WeisTekEng/openfixture/openfixture.scad

/**
 *  OpenFixture - The goal is to have a turnkey pcb fixturing solution
 *  as long as you have access to a laser cutter or laser cutting service.
 *
 *  The input is:
 *   1. (x, y) work area that is >= pcb size
 *   2. (x, y) cooridates of test point centers
 *   3. dxf of pcb outline aligned with (0,0) on the top left.
 *   4. Material parameters: acrylic thickness, kerf, etc
 *
 *  The output is a dxf containing all the parts (minus M3 hardware
 *  to assemble the fixture.
 *
 *  Creative Commons Licensed  (CC BY-SA 4.0)
 *  Tiny Labs
 *  2016
 */
 
use <Videopac.otf>
 
//
// PCB input
//

 // Test points
test_points = [
    [4.85, 19.95],
    [2.85, 21.25],
    [4.85, 22.45],
    [2.85, 23.7],
    [4.85, 24.95],
    [2.85, 26.2],
    [4.85, 27.45],
    [22.1, 18.8],
    [23.4, 30.95],
];

// Used below to calculate distance from hinge to nearest point based on min
// contact angle... Ideally we want it as close to 90 degrees as possible
// All you have to know is look through 'y' column above and set to lowest val
tp_min_y = 18.8;

// DXF outline of pcb
pcb_outline = "/home/elliot/projects/openfixture/keysy_outline.dxf";
osh_logo = "./osh_logo.dxf";


// Should be close to actual pcb dimensions... Used for support structure only so not critical
pcb_x = 27.14;
pcb_y = 45;
pcb_support_border = 2;

// Work area of PCB
// Must be >= PCB size
// If you make this as big as any of the PCBs you work with you could then reuse the base and just
// swap the head and carriers based on the pcb you're using 
work_area_x = 28;
work_area_y = 46;

// Thickness of pcb
pcb_th = 0.8;
//pcb_th = 1.6;  // Standard PCB size

// Correction offset
// These are final adjustments relative to the board carrier.
// Usually these aren't needed but can be used to tweak alignment
tp_correction_offset_x = 0.0;
tp_correction_offset_y = 0.0;

// Uncomment for alignment check, can be a quick sanity check to
// make sure everything lines up.
//projection (cut = false) alignment_check ();

// Uncomment for laser cuttable dxf
//projection (cut = false) lasercut (); // Uncomment for exportable dxf to laser cut
//3d_model (); // Uncomment for full 3d rendering
//3d_head ();  // Uncomment for 3d head rendering
//3d_base ();  // Uncomment for 3d base rendering 

//3D printing stuff. Export a piece at a time and import into your favorite
//software generate Gcode and print. A plate option will be done later.
//**BASE STUFF**
//3d_base_Spacers(); //sides of base.
//3d_base_hinge(); //Base Back side hinge.
//3d_base_supports();
//3d_base_bed_support();
//3d_base_bed_carrier();
//**END BASE STUFF**

//**TOP BED STUFF**
//3d_head_base();
//3d_head_side();
//3d_head_top();
//3d_front_back();
//**END TOP BED STUFF**
//
// End PCB input

// Smothness function for circles
$fn = 15;

// All measurements in mm
// Material parameters
// 0.10"
//mat_th = 2.5;
// 0.125" (1/8 ")
mat_th = 3.175;

// Kerf adjustment
kerf = 0.125;

// Space between laser parts
laser_pad = 2;

// Screw radius (we want this tight to avoid play)
// This should work for M3 hardware
// Just the threads, not including head
// Should be no less than 12
screw_thr_len = 14;
screw_d = 2.9;
screw_r = screw_d / 2;

// Uncomment to use normal M3 screw for pivot
pivot_d = screw_d;
// Uncomment to use bushing
//pivot_d = 5.12;
pivot_r = pivot_d / 2;

// Metric M3 hex nut dimensions
// f2f = flat to flat
nut_od_f2f = 5.45;
nut_od_c2c = 6;
nut_th = 2.25;

// Pogo pin receptable dimensions
// I use the 2 part pogos with replaceable pins. Its a lifer save when a pin breaks
// Undersized so they can be carefully drilled out using #48 drill bit for better precision
// If you have access to a nicer laser you can size these exactly
pogo_r = 1.5 / 2;

// Uncompressed length from receptacle
pogo_uncompressed_length = 8;
pogo_compression = 1;

// Locking tab parameters
tab_width = 3 * mat_th;
tab_length = 4 * mat_th;

// Stop tab
stop_tab_y = 2 * mat_th;

//
// DO NOT EDIT below unless you feel like it ;-)
//
// Calculate min distance to hinge with a constraint on
// the angle of the pogo pin when it meets compression with the board.
// a = compression
// c = active_y_offset + pivot_d
// cos (min_angle) = a^2 / (2ca)
//min_angle = 89.2;
min_angle = 89.5;

// Calculate active_y_back_offset
active_y_back_offset = (pow (pogo_compression, 2) / (cos (min_angle) * 2 * pogo_compression)) - pivot_d - tp_min_y;

// Active area parameters
active_x_offset = 2 * mat_th + nut_od_f2f + 2;
active_y_offset = 2 * mat_th + nut_od_f2f + 2;

// Head dimensions
head_x = work_area_x + 2 * active_x_offset;
head_y = work_area_y + active_y_offset + active_y_back_offset;
head_z = screw_thr_len + (mat_th - nut_th);

// Base dimensions
base_x = head_x + 2 * mat_th;
base_y = head_y + 2 * pivot_d;
base_z = screw_thr_len + 3 * mat_th;
base_pivot_offset = pivot_d + (pogo_uncompressed_length - pogo_compression) - (mat_th - pcb_th);

//
// MODULES
//
module tnut_female (n)
{
    // How much grip material
    tnut_grip = 4;
    
    // Pad for screw
    pad = 0.4;
    screw_len_pad = 1;
    
    // Screw hole
    translate ([0, -screw_r - pad/2, 0])
    cube ([screw_thr_len + screw_len_pad, screw_d + pad, mat_th]);
    
    // Make space for nut
    translate ([mat_th * n + tnut_grip, -nut_od_f2f/2, 0])
    cube ([nut_th, nut_od_f2f, mat_th]);
}

module tnut_hole ()
{
    pad = 0.1;
    cylinder (r = screw_r + pad, h = mat_th, $fn = 20);
}

module tng_n (length, cnt)
{
    tng_y = (length / cnt);
    
    translate ([0, -length / 2, 0])
    union () {
        for (i = [0 : 2 : cnt - 1]) {
            translate ([0, i * tng_y, 0])
            cube ([mat_th, tng_y, mat_th]);
        }
    }
}

module tng_p (length, cnt)
{
    tng_y = length / cnt;
    
    translate ([0, -length / 2, 0])
    union () {
        for (i = [1 : 2 : cnt - 1]) {
            translate ([0, i * tng_y, 0])
            cube ([mat_th, tng_y, mat_th]);
        }
    }
}


module spacer ()
{
    difference () {
        cylinder (r = screw_d, h = mat_th);
        cylinder (r = screw_r, h = mat_th);
    }
}

module nut_hole ()
{
    difference () {
        cylinder (r = nut_od_c2c/2, h = mat_th, $fn = 6);
        //cylinder (r = screw_r, h = mat_th, $fn = 20);
    }
}

module head_side ()
{
    x = head_z;
    y = head_y;
    r = pivot_d;
    
    difference () {
        union () {
            hull () {
                translate ([0, y, 0])
                cube ([x, 0.01, mat_th]);
                
                // Add pivot point
                translate ([r, y + r, 0])
                cylinder (r = r, h = mat_th, $fn = 20);
            }
            cube ([x, y, mat_th]);
        }
            
        // Remove pivot
        translate ([r, y + r, 0])
        cylinder (r = r/2, h = mat_th, $fn = 20);
        
        // Remove slots
        translate ([0, y / 2, 0])
        tng_n (y, 3);
        translate ([x - mat_th, y / 2, 0])
        tng_n (y, 3);
        
        // Remove lincoln log slots
        translate ([0, mat_th, 0])
        cube ([x / 2, mat_th, mat_th]);
        translate ([0, y - 2 * mat_th, 0])
        cube ([x / 2, mat_th, mat_th]);
    }
}

module head_front_back ()
{
    x = head_x + 2 * mat_th;
    y = head_z;
    
    difference () {
        cube ([x, y, mat_th]);
        
        // Remove grooves
        translate ([x / 2, 0, 0])
        rotate ([0, 0, 90])
        tng_n (x, 3);
        translate ([x / 2, y - mat_th, 0])
        rotate ([0, 0, 90])
        tng_n (x, 3);
        
        // Remove assembly slots
        translate ([2 *mat_th, y / 2, 0])
        cube ([mat_th, y / 2, mat_th]);
        translate ([x - 3 * mat_th, y / 2, 0])
        cube ([mat_th, y / 2, mat_th]);
    }
}

module lock_tab ()
{
    translate ([-tab_length/2, 0, 0])
    cube ([tab_length, tab_width, mat_th]);
    translate ([-tab_length/2, tab_width/2, 0])
    cylinder (r = tab_width / 2, h = mat_th, $fn = 20);
}

module head_base ()
{
    nut_offset = 2 * mat_th + screw_r;
    
    difference () {
        
        union () {
            // Common base
            head_base_common ();

            // Add stop tabs
            translate ([head_x, head_y - stop_tab_y + 2 * kerf, 0])
            cube ([mat_th, stop_tab_y, mat_th]);
            translate ([-mat_th, head_y - stop_tab_y + 2 * kerf, 0])
            cube ([mat_th, stop_tab_y, mat_th]);

            // Add lock tabs
            lock_tab ();
            translate ([head_x, 0, 0])
            mirror ([1, 0, 0])
            lock_tab ();

        }

        // Remove holes for hex nuts
        translate ([nut_offset, nut_offset, 0])
        nut_hole ();
        translate ([nut_offset, head_y - nut_offset, 0])
        nut_hole ();
        translate ([head_x - nut_offset, head_y - nut_offset, 0])
        nut_hole ();
        translate ([head_x - nut_offset, nut_offset, 0])
        nut_hole ();
        
        // Take 1/4 mouse bit out of front of tabs
        translate ([-2 * mat_th, 0, 0])
        cube ([mat_th, tab_width / 4, mat_th]);
        translate ([head_x + mat_th, 0, 0])
        cube ([mat_th, tab_width / 4, mat_th]);
    }
}
module osh_logo () {
    linear_extrude (height = mat_th)
    scale ([0.2, 0.2, 1])
    translate ([-72, -66, 0])
    import (osh_logo);
}

module head_top ()
{
    hole_offset = 2 * mat_th + screw_r;
    pad = 0.1;
    
    difference () {
        
        // Common base
        head_base_common ();
        
        // Remove holes for hex nuts
        translate ([hole_offset, hole_offset, 0])
        cylinder (r = screw_r + pad, h = mat_th);
        translate ([hole_offset, head_y - hole_offset, 0])
        cylinder (r = screw_r + pad, h = mat_th);
        translate ([head_x - hole_offset, head_y - hole_offset, 0])
        cylinder (r = screw_r + pad, h = mat_th);
        translate ([head_x - hole_offset, hole_offset, 0])
        cylinder (r = screw_r + pad, h = mat_th);

        // Add osh logo
        translate ([head_x / 2, head_y - 25, 0])
        osh_logo ();
    }
}

module head_base_common ()
{
    difference () {
        
        // Base cube
        cube ([head_x, head_y, mat_th]);
                
        // Remove slots
        translate ([mat_th, head_y / 2, 0])
        tng_p (head_y, 3);
        translate ([head_x - 2 * mat_th, head_y / 2, 0])
        tng_p (head_y, 3);
        translate ([head_x / 2, head_y - 2 * mat_th, 0])
        rotate ([0, 0, 90])
        tng_p (head_x + 2 * mat_th, 3);
        translate ([head_x / 2, mat_th, 0])        
        rotate ([0, 0, 90])
        tng_p (head_x + 2 * mat_th, 3);
        
        // Calc (x,y) origin = (0, 0)
        origin_x = active_x_offset;
        origin_y = active_x_offset + work_area_y;
    
        // Loop over test points
        for ( i = [0 : len (test_points) - 1] ) {
        
            // Drop pins for test points
            translate ([origin_x + test_points[i][0], origin_y - test_points[i][1], 0])
            cylinder (r = pogo_r, h = mat_th);
        }
    }
}

module latch ()
{
    pad = tab_width / 12;
    
    y = base_z * (2 / 3) + base_pivot_offset - pivot_d;
    difference () {
        
        hull () {
            cylinder (r = tab_width / 2, h = mat_th, $fn = 20);
            translate ([0, y + screw_d, 0])
            cylinder (r = tab_width / 2, h = mat_th, $fn = 20);
        }
        
        cylinder (r = screw_r, h = mat_th, $fn = 20);
        translate ([-screw_r, y - pad, 0])
        cube ([(3 * tab_width) / 4, mat_th + pad, mat_th]);
    }
}
module base_side ()
{
    x = base_z;
    y = base_y;
    
    difference () {
        union () {
            cube ([x, y, mat_th]);
            
            // Add pivot structure
            hull () {
                translate ([x + base_pivot_offset, y - pivot_d, 0])
                cylinder (r = pivot_d, h = mat_th, $fn = 20);
                translate ([0, y - 2 * pivot_d, 0])
                cube ([1, 2 * pivot_d, mat_th]);
            }
        }
        
        // Remove pivot hole
        translate ([x + base_pivot_offset, y - pivot_d, 0])
        cylinder (r = pivot_r, h = mat_th, $fn = 20);

        // Remove carrier slots
        translate ([x - mat_th, head_y / 2, 0])
        tng_p (head_y, 7);
        translate ([x - 2 * mat_th, head_y / 2, 0])
        tng_p (head_y, 7);
        
        // Remove tnut slot
        translate ([x, head_y / 2, 0])
        rotate ([0, 0, 180])
        tnut_female (2);
        
        // Offset from bottom
        support_offset = 2 * mat_th;
        
        // Cross bar support
        translate ([support_offset, head_y / 6 + screw_d + 2  * mat_th, 0])
        tng_n (head_y / 3, 3);
        translate ([support_offset + mat_th / 2, head_y / 6 + screw_d + 2 * mat_th, 0])
        tnut_hole ();
        
        // Second cross bar support
        translate ([support_offset, head_y - (head_y / 6 + mat_th), 0])
        tng_n (head_y / 3, 3);
        translate ([support_offset + mat_th / 2, head_y - (head_y / 6 + mat_th), 0])
        tnut_hole ();
        
        // Back support
        translate ([x/2 + mat_th, y - pivot_d - (mat_th / 2), 0])
        rotate ([0, 0, 90])
        tng_n (x, 3);
        translate ([x/2 + mat_th, y - pivot_d, 0])        
        tnut_hole ();
        
        // Remove locking pivot hole
        translate ([x / 3, tab_width / 2, 0])
        cylinder (r = screw_r, h = mat_th, $fn = 20);
    }
}

module base_support (length)
{
    x = base_x;
    y = length;
    
    difference () {
        // Base cube
        cube ([x, y, mat_th]);
        
        // Remove slots
        translate ([0, y / 2, 0])
        tng_p (y, 3);
        translate ([x - mat_th, y / 2, 0])
        tng_p (y, 3);
        
        // Remove female tnuts
        translate ([0, y / 2, 0])
        tnut_female (1);
        translate ([x, y / 2, 0])
        rotate ([0, 0, 180])
        tnut_female (1);
    }
}

module base_back_support ()
{
    difference () {
        union () {
            base_support (base_z);
        
            // Add additional support to receive pivot screw and nut
            translate ([3 * mat_th, base_z, 0])
            cube ([base_x - 6 * mat_th, base_pivot_offset + mat_th, mat_th]);
        }
        
        // Remove tnut supports
        translate ([0, base_z + base_pivot_offset - mat_th, 0])
        tnut_female (3);

        // Remove tnut supports
        translate ([base_x, base_z + base_pivot_offset - mat_th, 0])
        rotate ([0, 0, 180])
        tnut_female (3);
    }
}

module spacer ()
{
    difference () {
        cylinder (r = pivot_d, h = mat_th, $fn = 40);
        cylinder (r = pivot_r, h = mat_th, $fn = 20);
    }
}

module carrier (dxf_filename, pcb_x, pcb_y, border)
{
    x = base_x;
    y = head_y;
    
    // Calculate scale factors
    scale_x = 1 - ((2 * border) / pcb_x);
    scale_y = 1 - ((2 * border) / pcb_y);

    difference () {
        cube ([x, y, mat_th]);
        
        // Get scale_offset
        sx_offset = (pcb_x - (pcb_x * scale_x)) / 2;
        sy_offset = (pcb_y - (pcb_y * scale_y)) / 2;

        // Import dxf, extrude and translate
        translate ([mat_th + active_x_offset + tp_correction_offset_x, 
                   work_area_y + active_y_offset + tp_correction_offset_y, 0])
        translate ([sx_offset, -sy_offset, 0])
        hull () {
            linear_extrude (height = mat_th)
            scale ([scale_x, scale_y, 1])
            import (dxf_filename);
        }
        
        // Remove slots
        translate ([0, y/2, 0])
        tng_n (y, 7);
        translate ([x - mat_th, y/2, 0])
        tng_n (y, 7);
        
        // Remove holes
        translate ([mat_th / 2, y / 2, 0])
        tnut_hole ();
        translate ([x - mat_th / 2, y / 2, 0])
        tnut_hole ();
        
        // Add label to distinguish TOP
        translate ([x / 2, y - 10, 0])
        linear_extrude (height = mat_th)
        text ("top", font = "Videopac", halign = "center", size = 8);
    }
}

//
// 3D renderings of assembly
//

//support for 3d printing.
module 3d_base_Spacers() //print twice.
{
    // Base sides
    rotate ([0, -90, 0])
    base_side ();

    
    // Add spacers
    translate ([0, base_y - pivot_d, base_z + base_pivot_offset])
    rotate ([0, 90, 0])
    spacer ();
}

module 3d_base_hinge()
{
    base_back_support ();
}
    
module 3d_base_supports()
{
    translate ([-mat_th, 2 * screw_d + mat_th, 2 * mat_th])
    base_support (head_y / 3);
}

module 3d_base_bed_support()
{
    translate ([-mat_th, 0, base_z - (2 * mat_th)])
    carrier (pcb_outline, pcb_x, pcb_y, pcb_support_border);
}

module 3d_base_bed_carrier()
{
    translate ([-mat_th, 0, base_z - mat_th])
    carrier (pcb_outline, pcb_x, pcb_y, 0);
}

module 3d_head_base()
{
    head_top_offset = head_z - mat_th;
    head_base ();
}
module 3d_head_side()
{
    head_top_offset = head_z - mat_th;
    head_side ();
}
module 3d_head_top()
{
    head_top_offset = head_z - mat_th;
    head_top ();
}
module 3d_front_back()
{
    head_top_offset = head_z - mat_th;
    head_front_back ();
}

module 3d_head ()
{
    head_top_offset = head_z - mat_th;
    
    head_base ();
    translate ([2 * mat_th, 0, 0])
    rotate ([0, -90, 0])
    head_side ();
    translate ([head_x - mat_th, 0, 0])
    rotate ([0, -90, 0])
    head_side ();
    translate ([0, 0, head_top_offset])
    head_top ();
    translate ([-mat_th, head_y - mat_th, 0])
    rotate ([90, 0, 0])
    head_front_back ();
    translate ([-mat_th, 2 * mat_th, 0])
    rotate ([90, 0, 0])
    head_front_back ();
}

module 3d_base () {
    // Base sides
    rotate ([0, -90, 0])
    base_side ();
    translate ([head_x + mat_th, 0, 0])
    rotate ([0, -90, 0])
    base_side ();
    
    // Supports
    translate ([-mat_th, 2 * screw_d + mat_th, 2 * mat_th])
    base_support (head_y / 3);
    translate ([-mat_th, head_y - (head_y / 3) - mat_th, 2 * mat_th])
    base_support (head_y / 3);
    translate ([-mat_th, base_y - pivot_d + mat_th/2, mat_th])
    rotate ([90, 0, 0])
    base_back_support ();
    
    // Add spacers
    translate ([0, base_y - pivot_d, base_z + base_pivot_offset])
    rotate ([0, 90, 0])
    spacer ();
    translate ([base_x - 3 * mat_th, base_y - pivot_d, base_z + base_pivot_offset])
    rotate ([0, 90, 0])
    spacer ();
    
    // Add carrier blank and carrier
    translate ([-mat_th, 0, base_z - (2 * mat_th)])
    carrier (pcb_outline, pcb_x, pcb_y, pcb_support_border);
    translate ([-mat_th, 0, base_z - mat_th])
    carrier (pcb_outline, pcb_x, pcb_y, 0);
}

module 3d_model () {
    translate ([0, 0, base_z + base_pivot_offset - pivot_d])
    translate ([0, head_y + pivot_d, pivot_d])
    rotate ([-15, 0, 0])
    translate ([0, -head_y - pivot_d, -pivot_d])
    3d_head ();
    3d_base ();
    
    // Add latch
    translate ([-mat_th * 2, tab_width / 2, base_z / 3])
    rotate ([135, 0, 0])
    rotate ([0, 90, 0])
    latch ();
}

module alignment_check ()
{
    // Just need base and upper carrier
    head_base ();
    // Add board carrier
    translate ([head_x + tab_length, 0, 0])
    carrier (pcb_outline, pcb_x, pcb_y, 0);
}

module lasercut ()
{
    // Base components
    base_side ();
    translate ([2 * base_z + base_pivot_offset + pivot_d + laser_pad, base_y, 0])
    rotate ([0, 0, 180])
    base_side ();
    
    // Add latch
    yoffset = 2 * pivot_d + screw_d + 2 * laser_pad;
    xoffset = base_z + tab_width / 2 + laser_pad;
    translate ([xoffset, yoffset, 0])
    latch ();
    
    // Add spacers
    yoffset1 = yoffset + base_z + pivot_d + (3 * mat_th / 2) + screw_d + pivot_d + laser_pad;
    translate ([xoffset, yoffset1, 0])
    spacer ();
    yoffset2 = yoffset1 + 2 * pivot_d + laser_pad;
    translate ([xoffset, yoffset2, 0])
    spacer ();
    
    // Add base supports
    xoffset1 = 2 * base_z + base_pivot_offset + pivot_d + 2 * laser_pad;
    translate ([xoffset1, 0, 0])
    base_support (head_y / 3);
    yoffset3 = head_y / 3 + laser_pad;
    translate ([xoffset1, yoffset3, 0])
    base_support (head_y / 3);
    yoffset4 = yoffset3 + head_y / 3 + laser_pad;
    translate ([xoffset1, yoffset4, 0])
    base_back_support ();

    // Add heads
    xoffset2 = xoffset1 + 2 * base_x + tab_length;
    translate ([xoffset2, 0, 0])
    mirror ([1, 0, 0])
    head_base ();
    xoffset3 = xoffset2 + tab_length + laser_pad;
    translate ([xoffset3, 0, 0])
    head_top ();
    
    // Add carriers
    yoffset5 = -head_y - laser_pad;
    translate ([0, yoffset5, 0])
    carrier (pcb_outline, pcb_x, pcb_y, pcb_support_border);
    xoffset4 = base_x + laser_pad;
    translate ([xoffset4, yoffset5, 0])
    carrier (pcb_outline, pcb_x, pcb_y, 0);
    
    // Add sides
    xoffset5 = xoffset4 + base_x + laser_pad;
    yoffset6 = yoffset5 - 2 * pivot_d;
    translate ([xoffset5, yoffset6, 0])
    head_side ();
    xoffset6 = xoffset5 + head_z + laser_pad;
    translate ([xoffset6, yoffset6, 0])
    head_side ();
    xoffset7 = xoffset6 + head_z + laser_pad;
    translate ([xoffset7, -head_z - laser_pad, 0])
    head_front_back ();
    translate ([xoffset7, -2 * head_z - 2 * laser_pad, 0])
    head_front_back ();
}
