WeisTekEng/openfixture/(commit log)

2016-10-24 Updated script to support 3d printers
    Added functions to script to output single pieces to import into
    software, export gcode and print. will add plate feature later. This
    needs to be tested. Testing is in progress.
    [openfixture.scad]
2016-10-24 updated comments
    comments updated for 3d printer output.
    [openfixture.scad]
2016-10-24 updated title to reflect 3d printing changes.
